boumatsu/Buck-alone/02_Modelle/README.md

# 02_Modelle

Bauteilmodelle für LTspice und KiCad, ADI-Referenzschaltungen. In Simulationen nur mit **relativen** Pfaden einbinden, z. B. `.include ..\..\02_Modelle\LTspice\WE-XHMI\WE-XHMI.lib`.
