boumatsu/Buck-alone/04_Schaltplan_Layout/README.md

# 04_Schaltplan_Layout

KiCad-Projekt. Immer nur **eine KI-Sitzung bzw. nur ich** bearbeite Schaltplan oder Layout gleichzeitig (KiCad-Dateien lassen sich kaum zusammenführen). Layout-Vorgaben kommen aus `D_Filter_Platine/D04_Layout_Vorgaben/`.
