boumatsu/Buck-alone/06_Simulation_Gesamt/README.md

# 06_Simulation_Gesamt

Gemeinsames Buck-Modell (A13/B13) und Simulation der ganzen Kette Schutz → Filter → Buck (C10/D9). Simulationen, die nur ein Thema betreffen, liegen im Themenordner.
