boumatsu/Buck-alone/D_Filter_Platine/README.md

# D – Eingangsfilter, Stecker, LED, Messpunkte, Platinenrahmen, Zusammenführung

**Stand:** _Datum + ein Satz_

Arbeitsanleitung mit allen Schritten: [`D_Filter_Anschluesse_Platine_Zusammenfuehrung.md`](D_Filter_Anschluesse_Platine_Zusammenfuehrung.md).

## Themenordner
| Ordner | Schritte aus der Anleitung | Inhalt |
|---|---|---|
| `D01_Eingangsfilter/` | D4, D5, D9 | Filterkonzept, Filterbauteile, Filtersimulation |
| `D02_Stecker_LED_Messpunkte/` | D2, D6, D7 | Stecker, Status-LED, Messpunkte und Stellschrauben |
| `D03_Platinenrahmen/` | D3 | Lagen, Hersteller, Größe, Preis |
| `D04_Layout_Vorgaben/` | D10 | Layout-Vorgaben für KiCad (Layout macht die Gruppe) |

Übrige Schritte: D1 Vorbereitung → kein Ordner. D8 Zusammenführung und D11 Stückliste → `03_Stueckliste/`.

## Ergebnisse (Stand eintragen, wenn ein Wert feststeht)
| Größe | Wert | Quelle / Datei | Status |
|---|---|---|---|
| | | | |

## Stellschrauben für die Inbetriebnahme
- 

## Offene Punkte
-
