boumatsu/Buck-alone/A_Leistungsstufe/A03_MOSFETs_Schottky/README.md

# A03_MOSFETs_Schottky

FET-Spannungsklasse (mit C), Q101/Q102, D102. Schritte A6, A7, A8 aus [`../A_Leistungsstufe.md`](../A_Leistungsstufe.md).

Dateinamen beginnen mit `A03_` (Regeln in `AGENTS.md`).
