boumatsu/Buck-alone/A_Leistungsstufe/A06_Verluste_Thermik/README.md

# A06_Verluste_Thermik

Verlustbilanz und Temperatur. Schritte A11 aus [`../A_Leistungsstufe.md`](../A_Leistungsstufe.md).

Dateinamen beginnen mit `A06_` (Regeln in `AGENTS.md`).
