boumatsu/Buck-alone/B_Regelung/B05_IC_Pins/README.md

# B05_IC_Pins

FREQ, ILIM, Sense-Filter, INTVCC/EXTVCC/VIN, PGOOD. Schritte B9, B10, B11 aus [`../B_Regelung_und_IC-Beschaltung.md`](../B_Regelung_und_IC-Beschaltung.md).

Dateinamen beginnen mit `B05_` (Regeln in `AGENTS.md`).
