boumatsu/Buck-alone/C_Eingangsschutz/C01_Grenzen_Lastfaelle/README.md

# C01_Grenzen_Lastfaelle

Grenzen vom Buck, Lastfälle als LTspice-Modelle. Schritte C2, C3 aus [`../C_Eingangsschutz.md`](../C_Eingangsschutz.md).

Dateinamen beginnen mit `C01_` (Regeln in `AGENTS.md`).
