boumatsu/Buck-alone/D_Filter_Platine/D01_Eingangsfilter/README.md

# D01_Eingangsfilter

Filterkonzept, Filterbauteile, Filtersimulation. Schritte D4, D5, D9 aus [`../D_Filter_Anschluesse_Platine_Zusammenfuehrung.md`](../D_Filter_Anschluesse_Platine_Zusammenfuehrung.md).

Dateinamen beginnen mit `D01_` (Regeln in `AGENTS.md`).
