boumatsu/Buck-alone/D_Filter_Platine/D02_Stecker_LED_Messpunkte/README.md

# D02_Stecker_LED_Messpunkte

Stecker, Status-LED, Messpunkte und Stellschrauben. Schritte D2, D6, D7 aus [`../D_Filter_Anschluesse_Platine_Zusammenfuehrung.md`](../D_Filter_Anschluesse_Platine_Zusammenfuehrung.md).

Dateinamen beginnen mit `D02_` (Regeln in `AGENTS.md`).
