boumatsu/Buck-alone/D_Filter_Platine/D04_Layout_Vorgaben/README.md

# D04_Layout_Vorgaben

Layout-Vorgaben für KiCad (Layout macht die Gruppe). Schritte D10 aus [`../D_Filter_Anschluesse_Platine_Zusammenfuehrung.md`](../D_Filter_Anschluesse_Platine_Zusammenfuehrung.md).

Dateinamen beginnen mit `D04_` (Regeln in `AGENTS.md`).
