boumatsu/Buck-alone/01_Quellen/README.md

# 01_Quellen

Alle Quellen-PDFs (Q01…Q72) und die Quellenliste `01_Quellen_ApplicationNotes.md`. Neue Quellen: nächste freie Q-Nummer vergeben und in die Liste eintragen.
