boumatsu/Buck-alone/B_Regelung/README.md

# B – Regelung und LTC7800-Beschaltung

**Stand:** _Datum + ein Satz_

Arbeitsanleitung mit allen Schritten: [`B_Regelung_und_IC-Beschaltung.md`](B_Regelung_und_IC-Beschaltung.md).

## Themenordner
| Ordner | Schritte aus der Anleitung | Inhalt |
|---|---|---|
| `B01_Betriebsart_Teiler/` | B2, B3 | PLLIN/MODE, Ausgangsspannungsteiler |
| `B02_Ausgangskondensatoren/` | B4, B5 | Rippel-/Lastsprungziele, C_OUT |
| `B03_Kompensation/` | B6 | Regelkreis, Kompensation ITH |
| `B04_SoftStart_RUN/` | B7, B8 | C_SS, Einschaltschwelle RUN |
| `B05_IC_Pins/` | B9, B10, B11 | FREQ, ILIM, Sense-Filter, INTVCC/EXTVCC/VIN, PGOOD |

Übrige Schritte: B1 Vorbereitung → kein Ordner. B12 Stellschrauben → README dieses Bereichs und `D_Filter_Platine/D04_Layout_Vorgaben/`. B13 gemeinsames Buck-Modell → `06_Simulation_Gesamt/`. B14 Stückliste → `03_Stueckliste/`.

## Ergebnisse (Stand eintragen, wenn ein Wert feststeht)
| Größe | Wert | Quelle / Datei | Status |
|---|---|---|---|
| | | | |

## Stellschrauben für die Inbetriebnahme
- 

## Offene Punkte
-
