boumatsu/Buck-alone/C_Eingangsschutz/README.md

# C – Eingangsschutz: Verpolung, Überstrom, Surge, Burst, Hot-Plug

**Stand:** _Datum + ein Satz_

Arbeitsanleitung mit allen Schritten: [`C_Eingangsschutz.md`](C_Eingangsschutz.md).

## Themenordner
| Ordner | Schritte aus der Anleitung | Inhalt |
|---|---|---|
| `C01_Grenzen_Lastfaelle/` | C2, C3 | Grenzen vom Buck, Lastfälle als LTspice-Modelle |
| `C02_Verpolschutz/` | C4 | Verpolschutz-Optionen |
| `C03_Ueberstrom/` | C5 | Überstromschutz am Eingang |
| `C04_Surge_Burst/` | C6, C10 (Surge/Burst) | Klemmung, Surge- und Burst-Simulationen |
| `C05_Variantenvergleich/` | C7, C8 | Anordnung, Varianten A/B/C, Bewertung, gewählte Lösung dimensionieren |
| `C06_HotPlug/` | C9 | Hot-Plug |

Übrige Schritte: C1 Vorbereitung → kein Ordner. C10 Simulationen → im jeweiligen Themenordner; Gesamtkette in `06_Simulation_Gesamt/`. C11 Stückliste → `03_Stueckliste/`.

## Ergebnisse (Stand eintragen, wenn ein Wert feststeht)
| Größe | Wert | Quelle / Datei | Status |
|---|---|---|---|
| | | | |

## Stellschrauben für die Inbetriebnahme
- 

## Offene Punkte
-
