boumatsu/Buck-alone/A_Leistungsstufe/A02_Strommessung_Ausgangsschutz/README.md

# A02_Strommessung_Ausgangsschutz

R_SENSE R101, ILIM und Nachweis Überstromschutz am Ausgang (R13). Schritte A4 aus [`../A_Leistungsstufe.md`](../A_Leistungsstufe.md).

Dateinamen beginnen mit `A02_` (Regeln in `AGENTS.md`).
