boumatsu/Buck-alone/C_Eingangsschutz/C04_Surge_Burst/README.md

# C04_Surge_Burst

Klemmung, Surge- und Burst-Simulationen. Schritte C6, C10 (Surge/Burst) aus [`../C_Eingangsschutz.md`](../C_Eingangsschutz.md).

Dateinamen beginnen mit `C04_` (Regeln in `AGENTS.md`).
