boumatsu/Buck-alone/03_Stueckliste/altKI_BOM_Stueckliste.csv

Ref | Funktion | Wert/Typ | Hersteller | MPN | Gehaeuse | Menge | Mouser-PN (falls bekannt) | Status Verfuegbarkeit | Bemerkung | Entscheidungsstatus
U1 | Buck-Controller | LTC7800 | Analog Devices | LTC7800IUDC#PBF | QFN-20 3x4 | 1 | 584-LTC7800IUDCPBF | Mouser 2.982 Stk. (Mouser-Seite) | I-Grad -40..125C | schwer loetbar (Reflow/Heissluft) | VORLAEUFIG (S0/S1, nicht fix)
Q1 | Buck high-side FET | BSZ097N04LS G 40V | Infineon | BSZ097N04LSGATMA1 | TSDSON-8 3,3x3,3 | 1 | 726-BSZ097N04LSGATMA | ca. 29.500 (Aggregator), DigiKey 7.631 | Datenblatt-Beispiel-FET | BSZ063N04LS6 nicht lieferbar | VORLAEUFIG (S0/S1, nicht fix)
Q2 | Buck low-side FET | BSZ097N04LS G 40V | Infineon | BSZ097N04LSGATMA1 | TSDSON-8 3,3x3,3 | 1 | 726-BSZ097N04LSGATMA | wie Q1 |  | VORLAEUFIG (S0/S1, nicht fix)
L3 | Buck-Spule | 10 uH 6,5 mOhm 11,5 A | Wuerth | 74439370100 | WE-XHMI 1510 | 1 |  | Farnell 88 + 150 kommend | TrustedParts 6.001 | Kostenoption V2: 744393665100 (3,32 EUR, 15,4 mOhm, -0,27 Pkt. eta) | 74439346100 schlechter | Kernverlust via REDEXPERT pruefen | VORLAEUFIG (S0/S1, nicht fix)
RS1 | R_SENSE Buck (parallel) | 10 mOhm 1% 1W | Vishay | WSL2512R0100FEA | 2512 | 2 |  | Mouser ca. 2,1 Mio (Aggregator) | RS1||RS2 = 5 mOhm | Kelvin-Abgriff | VORLAEUFIG (S0/S1, nicht fix)
D_BOOT | Bootstrap-Diode | 40V 3A Schottky | Nexperia | PMEG4030ER-QX | SOD-123W | 1 | 771-PMEG4030ER-QX | ca. 3.000 (Aggregator) |  | VORLAEUFIG (S0/S1, nicht fix)
D_SYNC | Schottky ueber Q2 | 40V 3A Schottky | Nexperia | PMEG4030ER-QX | SOD-123W | 1 | 771-PMEG4030ER-QX | wie oben | optional per Messung bestaetigen (Qrr FET = 15 nC) | VORLAEUFIG (S0/S1, nicht fix)
C_B | Bootstrap-Kondensator | 0,22 uF 50 V X7R | Wuerth (WCAP-CSGP) | Code offen | 0805 | 1 |  | offen | >=100*Ciss(Q1)=140..190 nF | Wuerth 885012207098 (0,1 uF) ist zu klein | VORLAEUFIG (S0/S1, nicht fix)
C_INTVCC1 | INTVCC | 10 uF 50 V X7R | Wuerth | 885012209073 | 1210 | 1 |  | ca. 54.600 gelistet | 10x Spannungsverhaeltnis | VORLAEUFIG (S0/S1, nicht fix)
C_INTVCC2 | INTVCC nah am Pin | 1 uF 50 V X7R | Wuerth | 885012207103 | 0805 | 1 |  | ca. 86.900 gelistet |  | VORLAEUFIG (S0/S1, nicht fix)
C_VIN | VIN-Pin-Filter | 0,1 uF 100 V X7R |  | Code offen | 0805 | 1 |  | offen | Wert unkritisch | VORLAEUFIG (S0/S1, nicht fix)
R_IN | VIN-Pin-Vorwiderstand | 10 R 1% | Vishay o.ae. | z.B. CRCW080510R0FKEA | 0805 | 1 |  | Standardteil |  | VORLAEUFIG (S0/S1, nicht fix)
C_SENSE | SENSE-Filter | 1 nF C0G 50 V |  | Code offen | 0805 | 1 |  | offen | Wert aus LTC7800-Fig. 11 (angenommen) | VORLAEUFIG (S0/S1, nicht fix)
R_ITH | Kompensation | 2,2 k 1% |  | Standard | 0805 | 1 |  |  |  | VORLAEUFIG (S0/S1, nicht fix)
C_ITH | Kompensation | 10 nF C0G (sonst X7R) |  | Code offen | 0805/1206 | 1 |  | offen | C0G falls verfuegbar | VORLAEUFIG (S0/S1, nicht fix)
C_ITH2 | Kompensation HF | 100 pF C0G |  | Code offen | 0805 | 1 |  | offen |  | VORLAEUFIG (S0/S1, nicht fix)
C_SS | Soft-Start | 100 nF 50 V X7R | Wuerth | 885012207098 | 0805 | 1 |  | ca. 552.000 gelistet | t_SS = 8 ms | VORLAEUFIG (S0/S1, nicht fix)
R_FREQ | Frequenz | 33 k 1% |  | Standard | 0805 | 1 |  |  | ca. 502 kHz | VORLAEUFIG (S0/S1, nicht fix)
R_RUN_T | RUN-Teiler oben | 330 k 1% |  | Standard | 0805 | 1 |  |  |  | VORLAEUFIG (S0/S1, nicht fix)
R_RUN_B | RUN-Teiler unten | 22 k 1% |  | Standard | 0805 | 1 |  |  |  | VORLAEUFIG (S0/S1, nicht fix)
R1A | FB oben | 150 k 1% (0,1% moeglich) |  | Standard | 0805 | 1 |  |  |  | VORLAEUFIG (S0/S1, nicht fix)
R1B | FB oben | 18 k 1% |  | Standard | 0805 | 1 |  |  |  | VORLAEUFIG (S0/S1, nicht fix)
R2 | FB unten | 12 k 1% |  | Standard | 0805 | 1 |  |  |  | VORLAEUFIG (S0/S1, nicht fix)
C_FF | Feedforward (optional) | 10 pF C0G |  |  | 0805 | 0 |  |  | nicht bestuecken | VORLAEUFIG (S0/S1, nicht fix)
C_IN | Buck-Eingang Keramik | 4,7 uF 100 V X7R | Murata | GRM32ER72A475KE14L | 1210 | 6 |  | Existenz belegt | Mouser-Bestand offen | Worst-Case 15,4 uF | VORLAEUFIG (S0/S1, nicht fix)
C_OUT | Buck-Ausgang Keramik | 4,7 uF 100 V X7R | Murata | GRM32ER72A475KE14L | 1210 | 9 |  | wie oben | Worst-Case 27,7 uF | VORLAEUFIG (S0/S1, nicht fix)
C_BULK | Elko (2 am Stopper-OUT, 2 am Buck-Eingang) | 47 uF 35 V | Wuerth | 865080543009 | WCAP-ASLI 6,3x5,4 | 4 | 710-865080543009 | bei Mouser gelistet | Bestand offen | LTC4364 braucht >=22 uF Elko am OUT | VORLAEUFIG (S0/S1, nicht fix)
R_PU_PG | PGOOD-Pull-up | 100 k 1% |  | Standard | 0805 | 1 |  |  | nur an Zener-Rail, nicht INTVCC | VORLAEUFIG (S0/S1, nicht fix)
D_ZPG | 4,7-V-Zener-Rail | BZX84-C4V7 | Nexperia | BZX84-C4V7,215 | SOT-23 | 1 | 771-BZX84-C4V7-T/R | Mouser gelistet |  | VORLAEUFIG (S0/S1, nicht fix)
R_ZB | Zener-Vorwiderstand | 12 k 1% |  | Standard | 0805 | 1 |  |  |  | VORLAEUFIG (S0/S1, nicht fix)
Q_LED | LED-Schalter | BSS138 | onsemi | BSS138 | SOT-23 | 1 |  | DigiKey 733.000 |  | VORLAEUFIG (S0/S1, nicht fix)
R_LED | LED-Vorwiderstand | 10 k 1% |  | Standard | 0805 | 1 |  |  | 0,88 mA | VORLAEUFIG (S0/S1, nicht fix)
D_LED | Status-LED gruen | WL-SMCW 0603 | Wuerth | 150060GS75000 | 0603 | 1 | 710-150060GS75000 | Mouser gelistet (ca. 237.000) | Vf 3,2 V | VORLAEUFIG (S0/S1, nicht fix)
J1+ | Eingang + | 4-mm-Buchse rot PCB 24 A | Multicomp Pro | 24.243.1 | THT | 1 |  | Farnell/Newark (nicht Mouser) | Alternative Cliff S16N-PC | VORLAEUFIG (S0/S1, nicht fix)
J1- | Eingang - | 4-mm-Buchse schwarz PCB 24 A | Multicomp Pro | 24.243.2 (laut Multicomp-Datenblatt schwarz | gelb=24.243.3) | THT | 1 |  | wie oben | 60 VDC/24 A laut electrokit (ein Haendler nennt 30 VDC -> Datenblatt pruefen) | VORLAEUFIG (S0/S1, nicht fix)
J2+ | Ausgang + | wie J1+ | Multicomp Pro | 24.243.1 | THT | 1 |  |  |  | VORLAEUFIG (S0/S1, nicht fix)
J2- | Ausgang - | wie J1- | Multicomp Pro | 24.243.2 | THT | 1 |  |  |  | VORLAEUFIG (S0/S1, nicht fix)
F1 | Eingangssicherung | 5 A traege 125 V | Littelfuse | 0452005.MRL | NANO2 2410 | 1 |  | LCSC 16.830 | Mouser offen | R ca. 14 mOhm (Annahme) | VORLAEUFIG (S0/S1, nicht fix)
CMC1 | Gleichtaktdrossel | 14 uH 4 A | Wuerth | 744841414 | THT WE-CMB NiZn | 1 |  | Newark 310 | nicht E12 | bei Bedarf WE-CMB HC (0,7 mH) | VORLAEUFIG (S0/S1, nicht fix)
RV1 | Varistor | 39 V (VDC 31 V) 1 kA 9,4 J | Wuerth | 820542501 | THT 14 mm Scheibe | 1 |  | RS 10+55 Stk | knapp | Alternative 820512501 (500 A) | VORLAEUFIG (S0/S1, nicht fix)
L1 | Eingangsdrossel | 22 uH 13,3 mOhm 8 A | Wuerth | 74439370220 | WE-XHMI 1510 | 1 |  | RS zeitweise ausverkauft | TrustedParts 2.365 | Fallback 74439370150 (15 uH) | Kostenoption V2 fuer L2: 744393665100 (10 uH, EMV-Reserve nur 6,8 dB) | L1=L2=10 uH nicht ausreichend | VORLAEUFIG (S0/S1, nicht fix)
L2 | Drossel nach Stopper | 22 uH | Wuerth | 74439370220 | WE-XHMI 1510 | 1 |  | wie oben |  | VORLAEUFIG (S0/S1, nicht fix)
D_TVS | TVS | 28 V bidirektional 3 kW | Wuerth | 824551281 | DO-214AB (SMC) | 1 | 710-824551281 | Mouser ca. 185 (Aggregator) | =SMDJ28CA | 8/20-us-Kurve ablesen | VORLAEUFIG (S0/S1, nicht fix)
U2 | Surge Stopper + Ideal Diode | LTC4364-2 (Auto-Retry) | Analog Devices | LTC4364IS-2#PBF | SO-16 | 1 |  | DigiKey/Aggregatoren | MSOP-Variante LTC4364IMS-2#PBF DigiKey 3.284 | Mouser offen | VORLAEUFIG (S0/S1, nicht fix)
M1 | Stopper-Pass-FET | 100 V 8 mOhm | onsemi | FDMS86101 | PQFN8 5x6 | 1 |  | DigiKey 29.229, Newark 1.304 | SOA-Kurve ablesen | VORLAEUFIG (S0/S1, nicht fix)
M2 | Ideal-Diode-FET | 100 V 8 mOhm | onsemi | FDMS86101 | PQFN8 5x6 | 1 |  | wie M1 |  | VORLAEUFIG (S0/S1, nicht fix)
RSNS | Stopper-Sense | 10 mOhm 1% 1W | Vishay | WSL2512R0100FEA | 2512 | 1 |  | Mouser ca. 2,1 Mio (Aggregator) |  | VORLAEUFIG (S0/S1, nicht fix)
R4 | VCC-Filter | 2,2 k |  | Standard | 0805 | 1 |  |  |  | VORLAEUFIG (S0/S1, nicht fix)
C1 | VCC-Filter | 0,1 uF 100 V X7R |  | Code offen | 0805 | 1 |  |  |  | VORLAEUFIG (S0/S1, nicht fix)
R5 | Gate-Widerstand M1 | 10 R |  | Standard | 0805 | 1 |  |  |  | VORLAEUFIG (S0/S1, nicht fix)
D_G1 | Gate-Zener M1 | 15 V | Diodes Inc. | DDZ9702-7 | SOD-123 | 1 | 621-DDZ9702-7 | Mouser ca. 13.200 (Aggregator) | nicht SOD-523 (zu klein) | VORLAEUFIG (S0/S1, nicht fix)
D_G2 | Gate-Zener M2 | 15 V | Diodes Inc. | DDZ9702-7 | SOD-123 | 1 | 621-DDZ9702-7 | wie oben |  | VORLAEUFIG (S0/S1, nicht fix)
C_HG | HGATE-Kondensator | 6,8 nF |  | Code offen | 0805 | 1 |  |  |  | VORLAEUFIG (S0/S1, nicht fix)
R6 | optional 100 R + D5 1N4148W |  |  |  | 0805/SOD-123 | 0 |  |  | laut Datenblatt Fig. 1 optional | VORLAEUFIG (S0/S1, nicht fix)
R7 | Klemme oben | 100 k 1% |  | Standard | 0805 | 1 |  |  |  | VORLAEUFIG (S0/S1, nicht fix)
R8 | Klemme unten | 4,7 k 1% |  | Standard | 0805 | 1 |  |  |  | VORLAEUFIG (S0/S1, nicht fix)
R1U | UV/OV oben | 220 k 1% |  | Standard | 0805 | 1 |  |  |  | VORLAEUFIG (S0/S1, nicht fix)
R2U | UV/OV Mitte | 8,2 k 1% |  | Standard | 0805 | 1 |  |  |  | VORLAEUFIG (S0/S1, nicht fix)
R3U | UV/OV unten | 10 k 1% |  | Standard | 0805 | 1 |  |  |  | VORLAEUFIG (S0/S1, nicht fix)
C_TMR | Fehler-Timer | 47 nF C0G (1206) oder X7R |  | Code offen | 1206 | 1 |  | offen | genaue Kapazitaet mit niedrigem Spannungs- und Temperatur-Koeffizienten (Datenblatt) | VORLAEUFIG (S0/S1, nicht fix)
D_68V | VCC-Zener (optional) | 68 V | Central | CMZ5945B (Datenblatt) | SMB | 0 |  |  | nur noetig bei Spannungen > 80 V am VCC | Simulation max 59,6 V | VORLAEUFIG (S0/S1, nicht fix)
