boumatsu/Buck-alone/03_Stueckliste/README.md

# 03_Stueckliste

Gemeinsame Stückliste und Budget. Bauteilkandidaten je Bereich in `02_Bauteilkandidaten.md`, Format der Stückliste in `Stueckliste_Vorlage.csv`. Alle Bereiche tragen hier ein, nicht in eigenen Listen. Gemeinsam genutzte Datei: vor dem Ändern `git pull`, kleine Commits.
