boumatsu/Buck-alone/03_Stueckliste/altKI_Kosten_Preisliste.csv

Ref | Teil | Stk/Board | Preis_V1_EUR_netto | Preis_V2_kostenoptimiert_EUR_netto | Quelle/Qualitaet | Ersatz_S1_Stk | Ersatz_S2_Stk | Status
U1 | LTC7800IUDC#PBF | 1 | 10.75 | 10.75 | belegt: Mouser EU 1 Stk. 10,75 EUR | 0 | 1 | VORLAEUFIG (S0/S1)
U2 | LTC4364IS-2#PBF (MSOP-Preis als Basis) | 1 | 11.15 | 11.15 | Beleg MSOP: DigiKey 12,12 USD x0,92 | 0 | 1 | VORLAEUFIG (S0/S1)
Q1,Q2 | BSZ097N04LS G | 2 | 0.81 | 0.81 | Aggregator: Mouser 0,88 USD x0,92 | 2 | 2 | VORLAEUFIG (S0/S1)
M1,M2 | FDMS86101 | 2 | 2.05 | 2.05 | Aggregator: ca. 2,23 USD x0,92 | 2 | 2 | VORLAEUFIG (S0/S1)
L3 | Buck-Spule V1: Wuerth 74439370100 / V2: 744393665100 | 1 | 5.97 | 3.32 | V1 belegt: Farnell DK 44,57 DKK; V2 belegt: Farnell IT 3,32 EUR (1+) | 0 | 1 | VORLAEUFIG (S0/S1)
L1 | Wuerth 74439370220 (22 uH) | 1 | 6.11 | 6.11 | belegt: RS NL 12,22 EUR/2 Stk. | 0 | 1 | VORLAEUFIG (S0/S1)
L2 | V1: 74439370220 (22 uH) / V2: 744393665100 (10 uH) | 1 | 6.11 | 3.32 | belegt (s.o.); V2: EMV-Reserve nur 6,8 dB (Simulation) | 0 | 1 | VORLAEUFIG (S0/S1)
CMC1 | Wuerth 744841414 | 1 | 3.21 | 3.21 | Aggregator: Mouser 3,49 USD x0,92; RS 2,85 GBP | 0 | 1 | VORLAEUFIG (S0/S1)
D_TVS | Wuerth 824551281 | 1 | 1.57 | 1.57 | Aggregator: Mouser 1,71 USD x0,92 | 1 | 1 | VORLAEUFIG (S0/S1)
RV1 | Wuerth 820542501 | 1 | 0.78 | 0.78 | belegt: RS FR 3,90 EUR/5 Stk. | 1 | 1 | VORLAEUFIG (S0/S1)
F1 | Littelfuse 0452005.MRL | 1 | 0.60 | 0.60 | SCHAETZUNG | 2 | 2 | VORLAEUFIG (S0/S1)
RS | WSL2512R0100FEA (3 Stk.) | 3 | 0.39 | 0.39 | Aggregator: Mouser 0,42 USD x0,92 | 1 | 1 | VORLAEUFIG (S0/S1)
D_BOOT,D_SYNC | PMEG4030ER-QX | 2 | 0.41 | 0.41 | belegt: DigiKey 1 Stk. 0,41 EUR | 1 | 1 | VORLAEUFIG (S0/S1)
C_INTVCC1 | Wuerth 885012209073 (10 uF/50 V) | 1 | 0.70 | 0.70 | SCHAETZUNG | 1 | 1 | VORLAEUFIG (S0/S1)
C_INTVCC2/C_SS | Wuerth 885012207103 / 885012207098 | 2 | 0.20 | 0.20 | SCHAETZUNG | 1 | 1 | VORLAEUFIG (S0/S1)
C_B | Wuerth 0,22 uF/50 V (Code offen) | 1 | 0.15 | 0.15 | SCHAETZUNG | 1 | 1 | VORLAEUFIG (S0/S1)
C0G | C0G-Kondensatoren (C_SENSE, C_ITH, C_ITH2, C_TMR) | 4 | 0.25 | 0.25 | SCHAETZUNG | 2 | 2 | VORLAEUFIG (S0/S1)
C_VIN,C1 | 0,1 uF/100 V X7R 0805 | 2 | 0.15 | 0.15 | SCHAETZUNG | 1 | 1 | VORLAEUFIG (S0/S1)
C_IN,C_OUT | Murata GRM32ER72A475KE14L (6+9 Stk.) | 15 | 0.50 | 0.50 | SCHAETZUNG (robu 29 INR ~0,30 EUR; Mouser-Preis offen) | 3 | 3 | VORLAEUFIG (S0/S1)
C_BULK | Wuerth 865080543009 Elko 47 uF/35 V | 4 | 0.40 | 0.40 | SCHAETZUNG (RS 0,156 GBP bei 125 Stk.) | 1 | 1 | VORLAEUFIG (S0/S1)
R | Widerstaende E12 0805 (ca. 22 Stk.) | 22 | 0.10 | 0.10 | SCHAETZUNG (Einzelpreis; Sortiment guenstiger) | 8 | 8 | VORLAEUFIG (S0/S1)
Q_LED etc. | BSS138, BZX84-C4V7, 2x DDZ9702-7, LED 150060GS75000 | 5 | 0.12 | 0.12 | SCHAETZUNG | 3 | 3 | VORLAEUFIG (S0/S1)
J1,J2 | Multicomp Pro 24.243.1/.2 Bananenbuchse | 4 | 1.13 | 1.13 | belegt: electrokit 12,50 SEK x0,09 (inkl. 25 % SE-MwSt.) | 0 | 0 | VORLAEUFIG (S0/S1)
