boumatsu/Buck-alone/03_Stueckliste/Stueckliste_Vorlage.csv

Bereich | Referenz | Funktion | Wert | Toleranz | Nennspannung_V | Nennstrom_A_oder_Leistung_W | Gehaeuse | Hersteller | Hersteller_Teilenummer | Datenblatt_Link_und_Revision | Haendler_1 | Bestellnummer_1 | Preis_1_EUR_netto_je_Stueck | bei_Stueckzahl_1 | Bestand_1 | Datum_1 | Haendler_2 | Bestellnummer_2 | Preis_2_EUR_netto_je_Stueck | bei_Stueckzahl_2 | Bestand_2 | Datum_2 | Menge_pro_Platine | Status | Alternative | Bemerkung
A | R101 | BEISPIELZEILE Strommesswiderstand | 6 mOhm | 1 % |  | 1 W | 2512 | <Hersteller> | <Teilenummer> | <Link, Rev.> | Mouser | <Nr.> | <Preis> | 10 | <Bestand> | 2026-10-12 | Farnell | <Nr.> | <Preis> | 10 | <Bestand> | 2026-10-12 | 1 | Vorschlag | <Alternativteil> | Beispielzeile - loeschen
