boumatsu/Buck-alone/02_Modelle/Referenzschaltungen_ADI/LTC4364-2_TA01A.asc

C1: cap; 6.8n
C2: cap; 6.8u
C3: cap; 0.1u
C4: cap; 22u; Rser=100m
D1: zener; 1N5373B
Q1: nmos; FDB33N25
Q2: nmos; FDB3682
R1: res; 383K
R2: res; 10K
R3: res; 10m
R4: res; 10
R5: res; 102K
R6: res; 4.99K
R7: res; 100K
R8: res; 100K
R9: res; 2.2K
R10: res; 90.9K
Rload: res; 7
U1: LTC4364-2
V1: voltage; PWL(0 0 +20u 12 +.1 12 +20u 80; +.3 12 +.1 12 +20u 200 +1m 200
Named nets: 0, IN, OUT
.tran .7
LTC4364 - Surge Stopper with Ideal Diode
4A, 12V Overvoltage Output Regulator with Reverse Current Protection
Withstands 200V 1ms & -24V Transient at Vin
Note:
  If the simulation model is not found please update with the "Sync Release" command from the "Tools" menu.
  It remains the customer's responsibility to verify proper and reliable operation in the actual application.
  Component substitution and printed circuit board layout may significantly affect circuit performance or reliability.
  Contact your local sales representative for assistance. This circuit is distributed to customers only for use with LTC parts.
  Copyright © 2014 Linear Technology Inc. All rights reserved.
