boumatsu/Buck-alone/(commit log)

2026-10-12 Persönliches Arbeits-Repo LTC7800-Buck angelegt
    Gleiche Struktur wie das Gruppen-Repo, ausgelegt auf eine Person mit
    1-2 KI-Assistenten: AGENTS.md/CLAUDE.md, STATUS.md mit Übergaben,
    ohne _eingang-Ordner und Zuständigkeiten.
    Claude-Session: https://claude.ai/code/session_0164HY2JRypcU36vCWeSbMbo
2026-10-13 Designablauf und Werkzeuge (LTspice, KiCad) ergänzt
    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
2026-10-13 Designablauf: Kern (LTC7800 + Leistungsstufe) von Ein- und Ausgangsseite getrennt
    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
